msaltnet/coding-camp/_article/intro.md

author: Jeong Seongmoon
summary: 강의 소개
id: introduce
categories: codelab
environments: Web
status: Published
feedback link: https://github.com/msaltnet/coding-camp

# 강의 소개

## 강사소개
Duration: 0:01:00

맛소금 - https://me.msalt.net

## 오늘 우리가 만들것
Duration: 0:05:00

무엇으로 구성되어 있는지 등

## 중요한 것!
당장은 재미있게 즐기기 그리고 천천히 생각해보기!!!

재료는 집에 가지고 갈 수 있고, 자료는 집에서도 볼 수 있으니 잘 이해가 안된다고 답답해하지 말고, 나중에 다시 시작해봐도 좋아요.
