msaltnet/coding-camp/_article/03_LED/img/Light-Emitting-Diode-3.png

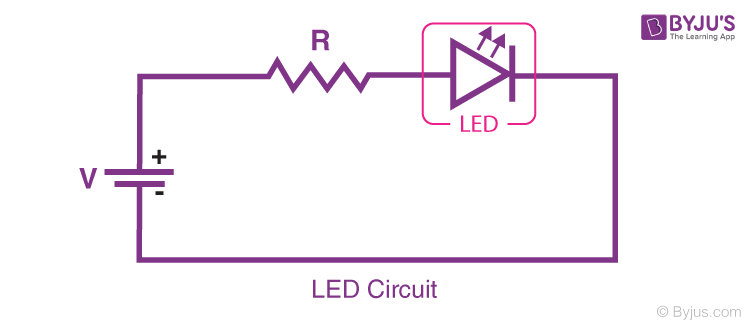
_article/03_LED/img/Light-Emitting-Diode-3.png
