msaltnet/coding-camp/_article/95_smartcar/img/circuit.jpg

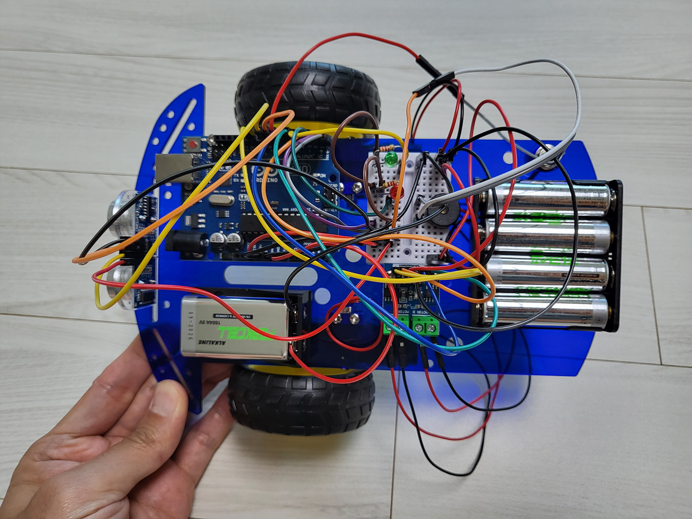
_article/95_smartcar/img/circuit.jpg
