msaltnet/coding-camp/car-bt/img/6ab0c9ccaa84dc1d.png

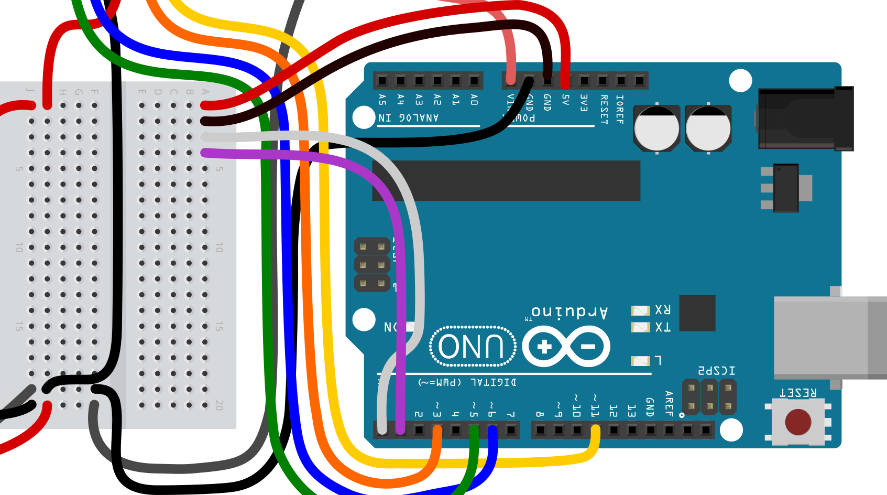
car-bt/img/6ab0c9ccaa84dc1d.png
