msaltnet/coding-camp/car-circuit/img/4ec3165606cc51a2.png

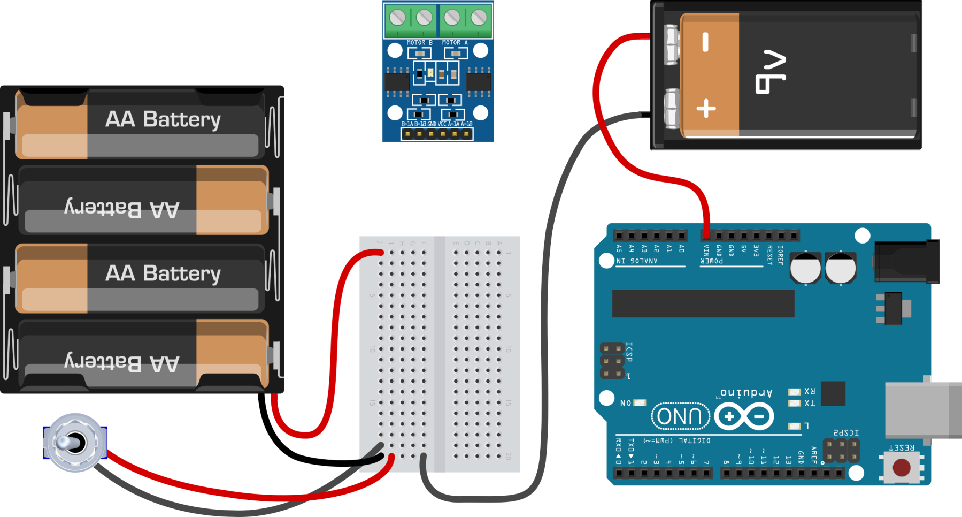
car-circuit/img/4ec3165606cc51a2.png
