msaltnet/coding-camp/car-circuit/img/92229d2687967926.png

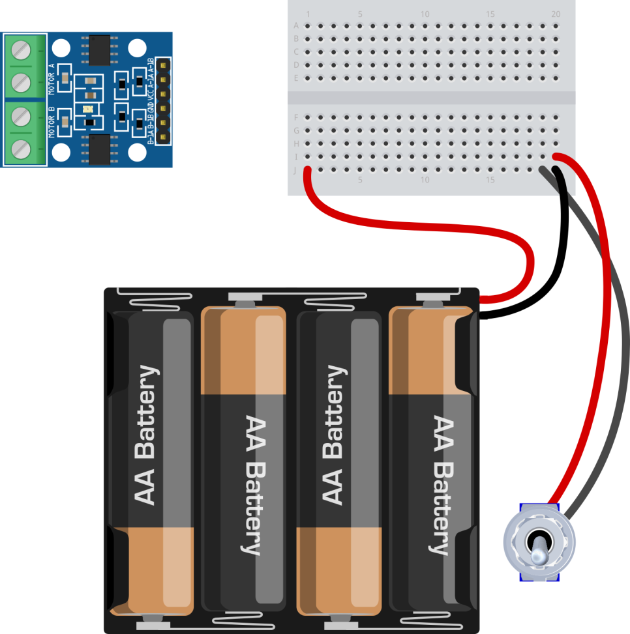
car-circuit/img/92229d2687967926.png
