msaltnet/coding-camp/car-circuit/img/a8d2233a3b8fe34a.png

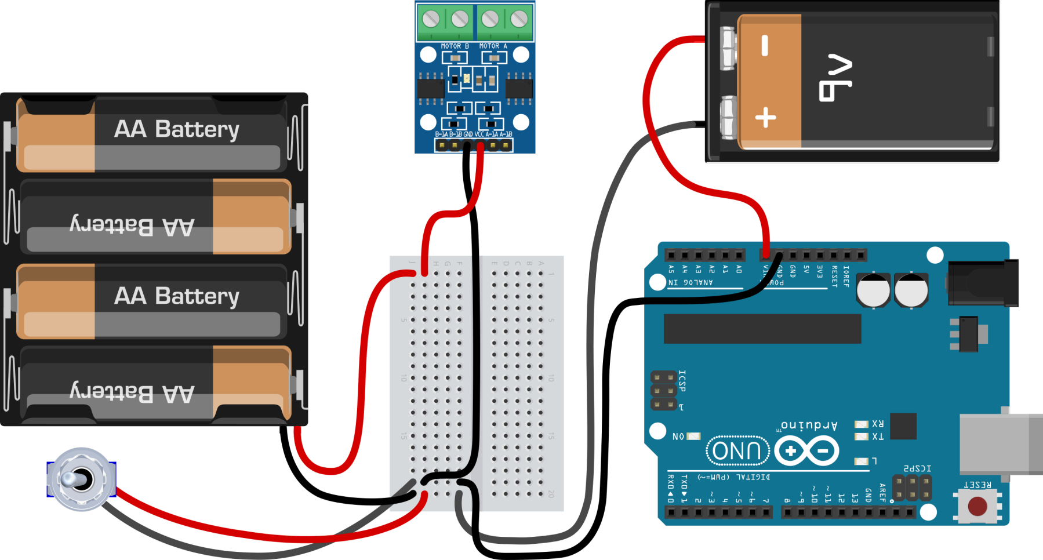
car-circuit/img/a8d2233a3b8fe34a.png
