msaltnet/coding-camp/car-circuit/img/f463cd654dd91e19.png

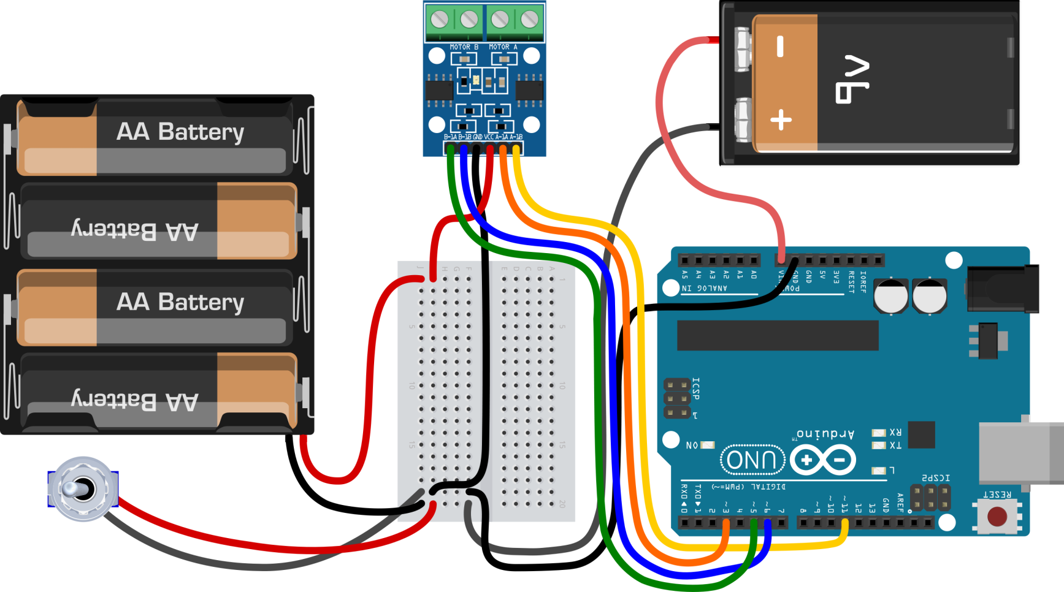
car-circuit/img/f463cd654dd91e19.png
