msaltnet/coding-camp/smart-car/img/7307ecca29c45d2a.png

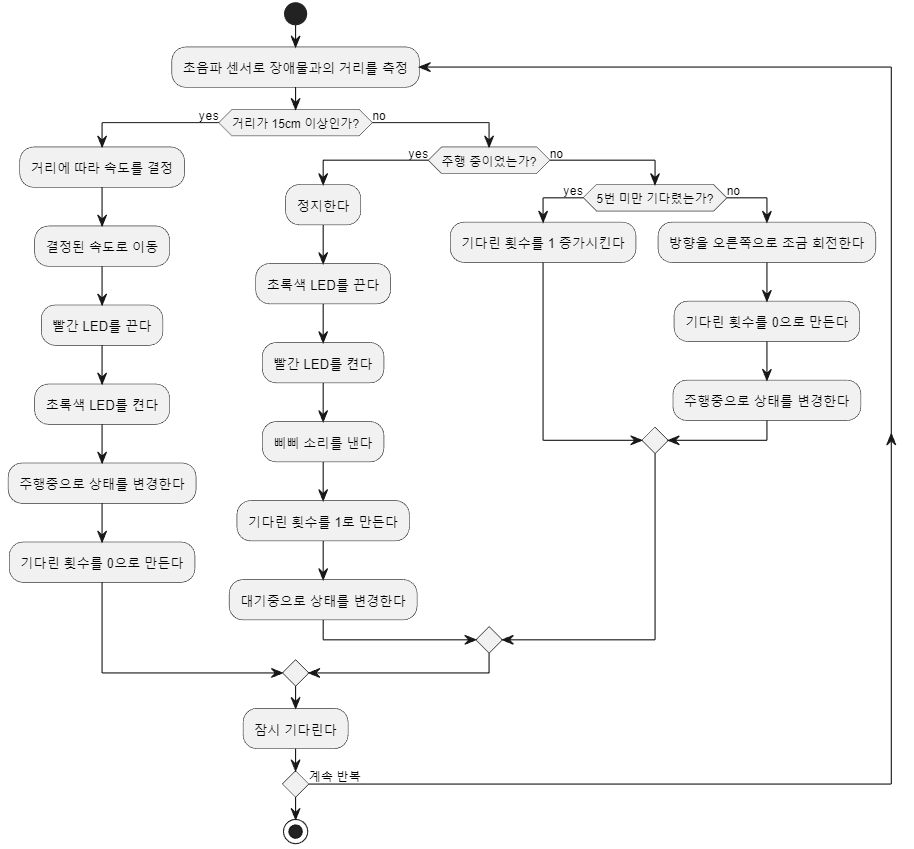
smart-car/img/7307ecca29c45d2a.png
