msaltnet/coding-camp/_article/HOT_TO_MAKE_CODELAB.md

# code lab

코드랩 만드는 방법

1. `_article` 폴더에 `.md` 파일로 생성한다. sample을 참고
2. `claat-windows-amd64.exe export <md file>` 실행해서 static 파일 폴더 생성
3. `claat-windows-amd64.exe serve` 실행해서 로컬에서 확인
4. static 파일 폴더를 `root` 폴더에 복사
5. 커밋 생성하여 푸쉬

회로도는 https://www.tinkercad.com/dashboard
