msaltnet/coding-camp/(commit log)

2023-08-08 add led article
2023-08-08 add led assets
2023-08-18 add arduino IDE image
2023-08-18 add ultrasound sensor image
2023-08-19 add photo and circuit
2023-08-20 update assets for 2 led
2023-08-20 update assets for car circuit
